tessel/t2-hardware/(threads)

Thread 11 (2015-12-19):

Update Silk For Production

johnnyman727, 2015-12-19:
Required:
- [ ] Add the [CE/FCC](http://www.sxmregulator.sx/sites/default/files/imagecache/view-850/sites/default/files/fcc_and_ce_logo.jpg) logo to a convenient place on the bottom of the board
- [ ] Update the revision tag to `TM-T2-06` (the changes with CE-approved electronics should have been `TM-T2-05` but we didn't update the silk)
- [ ] Change "Made with love by Technical Machine" to "Made with love by The Tessel Project

Optional:
- [ ] @tcr mentioned the desire to update the silk screen next to each of the pins but I'm not sure exactly what to change them to or if we even have room
- [ ] @rwaldron would like the Servo Module to have it's pins zero indexed instead of 1 for compatibility with the Johnny-Five library.

Anyone else have thoughts on this? @jiahuang @Frijol @kevinmehall @tcr @rwaldron

reconbot, 2015-12-20:
The normal module pins are also zero indexed aren't they?
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

rwaldron, 2015-12-20:
> for compatibility with the Johnny-Five library.

s/Johnny-Five library/universe/

rwaldron, 2015-12-20:
Also, it works fine with Johnny-Five.

dtex, 2015-12-20:
what Rick said

>:-(

Love y'all but seriosuly

>:-(

Frijol, 2015-12-20:
sounds good to me! The only thing I wish was better is that the labeling of what each of the pins actually is is on the back, and no one looks there... but not sure there's room on the silk to fix this.

reconbot, 2015-12-21:
I love pin labeling it makes life so much easier.

Student007, 2015-12-21:
:+1: pin labels

rwaldron, 2015-12-21:
😃

studentdanbu, 2016-09-29:
Hello Tessel-Team 😄

maybe this is not the right place for the question but it came up while planing a low scaled product.

Are there any cases you use with the Tessel 2 like those from [Spark-Fun](https://www.sparkfun.com/search/results?term=case) ?

It is about fitting external ports or used modules and of cause the screws the Tessel itself provides 4 holes to fix it in the case.

I think this is one of my major things I am unsure using the Tessel for a product (RasPi has a case on Spark Fun). If I would find a useful box I can put on a sticker ... this would be a great thing.

johnnyman727, 2016-09-29:
@studentdanbu you might want to ask on [Tessel Slack](tessel-slack.herokuapp.com) in the #community channel. I believe someone has made cases for T2 before.

Thread 16 (2016-09-22):

Outdated BOM

dbuentello, 2016-09-22:
Regenerate: https://github.com/tessel/t2-hardware/blob/master/bom/tessel-v2-parts.csv

Outdated parts:
- ATSAMD21G15A is actually g17

Im sure there are more but gave up after generator didnt work (still investigate this)

johnnyman727, 2016-09-22:
[Here is a BOM that I found from the Technical Machine archives](https://docs.google.com/spreadsheets/d/1hgn9fT9eEDG23kPYqsrsC8mXqOHHuY68sc9VK9puuPo/edit#gid=1633415522) (I scrubbed it of any pricing information in case that... matters to anyone).

It was from revision 3 of the board but we ended up producing version 4. I'm not sure if anything had changed. @ekolker might know.

Additionally, we are in the process of evaluation replacements for L201, L202, and U901 (they are End of Life). L201/2 would be replaced with MLG1005S3N9BT000 and U901 would be replaced with AP2166SGDITR-ND. @rwaldron should be able to confirm once a reworked T2 arrives at his house in a week or so.
