tessel/t2-hardware/(commit log)

2014-12-13 swapped to tm lib, 11x17 sheet size
    [mediatek.sch, v2.sch]
2014-12-13 top level hierarchy
    [mediatek.sch, v2.sch]
2014-12-13 second level schematic sheets
    [tessel-v2-coprocessor.sch, tessel-v2-io.sch, tessel-v2-power.sch]
2014-12-13 renamed files, added sub-sheets
    [tessel-v2-coprocessor.sch, tessel-v2-io.sch, tessel-v2-mediatek.sch, tessel-v2-power.sch, tessel-v2.sch]
2014-12-13 labels do not need to be bold
    [tessel-v2-mediatek.sch]
2014-12-13 added subsub schematics
    [tessel-v2-coprocessor.sch, tessel-v2-io.sch, tessel-v2-mediatek-flash.sch, tessel-v2-mediatek-ram.sch, tessel-v2-mediatek-rf.sch, tessel-v2-mediatek.sch, tessel-v2-power.sch, tessel-v2.sch]
2014-12-13 title block to all sheets
    [tessel-v2-coprocessor.sch, tessel-v2-io.sch, tessel-v2-mediatek-flash.sch, tessel-v2-mediatek-ram.sch, tessel-v2-mediatek-rf.sch, tessel-v2-mediatek.sch, tessel-v2-power.sch, tessel-v2.sch]
2014-12-14 moved RAM
    [tessel-v2-coprocessor.sch, tessel-v2-io.sch, tessel-v2-mediatek-ram.sch, tessel-v2-mediatek.sch, tessel-v2-power.sch]
2014-12-14 git/kicad test: added samd21 to coprocessor sheet
    [tessel-v2-coprocessor.sch]
2014-12-14 connecting ram
    [tessel-v2-mediatek-ram.sch]
2014-12-14 sam io labeled
    [tessel-v2-coprocessor.sch]
2014-12-14 sam io broken out to h.labels
    [tessel-v2-coprocessor.sch, tessel-v2.sch]
2014-12-14 g3 for port a, b
    [tessel-v2-coprocessor.sch, tessel-v2.sch]
2014-12-14 added ddr
    [tessel-v2-mediatek-ram.sch]
2014-12-15 coprocessor fully decoupled, etc.
    [tessel-v2-coprocessor.sch]
2014-12-15 changed 5k to 4.7k
    [tessel-v2-mediatek-ram.sch]
2014-12-15 edited samd21 sym, started power things
    [tessel-v2-coprocessor.sch, tessel-v2-mediatek-ram.sch, tessel-v2-power.sch]
2014-12-15 power plant skeleton in place
    [tessel-v2-power.sch]
2014-12-16 adding io
    [tessel-v2-io.sch, tessel-v2-mediatek.sch]
2014-12-16 somehow the libs got de-associated?
2014-12-16 readding ram
    [tessel-v2-mediatek-ram.sch]
2014-12-16 adding flash
    [tessel-v2-mediatek-flash.sch]
2014-12-16 added load switches to power schem
    [tessel-v2-power.sch]
2014-12-16 added mediatek power
    [tessel-v2-mediatek-ram.sch, tessel-v2-mediatek.sch]
2014-12-16 adding more caps
    [tessel-v2-mediatek.sch]
2014-12-16 power is mostly done
    [tessel-v2-io.sch, tessel-v2-mediatek.sch, tessel-v2-power.sch]
2014-12-16 swapped in power labels
    [tessel-v2-coprocessor.sch, tessel-v2-mediatek-flash.sch, tessel-v2-mediatek-ram.sch, tessel-v2-mediatek.sch, tessel-v2-power.sch]
2014-12-16 readding io
    [tessel-v2-io.sch]
2014-12-16 updating main schem
    [tessel-v2.sch]
2014-12-16 adding mediatek flash labels
    [tessel-v2-mediatek.sch]
2014-12-16 rf chain done (*starts praying*)
    [tessel-v2-mediatek-rf.sch]
2014-12-16 post-sch review 1. power issues addressed
    [tessel-v2-power.sch]
2014-12-16 added power h.labels to top schem
    [tessel-v2.sch]
2014-12-16 labels and series R for MT comms
    [tessel-v2-coprocessor.sch]
2014-12-17 cp pins into top sch
    [tessel-v2.sch]
2014-12-17 cleaning up ram, rf, and mediatek power
    [tessel-v2-mediatek-ram.sch, tessel-v2-mediatek-rf.sch, tessel-v2-mediatek.sch]
2014-12-17 io pins, jtag, cortex, high level pins
    [tessel-v2-coprocessor.sch, tessel-v2-io.sch, tessel-v2.sch]
2014-12-17 wiring up more i/o to cp
    [tessel-v2-coprocessor.sch, tessel-v2-io.sch, tessel-v2.sch]
2014-12-17 added power reg to downstream usb
    [tessel-v2-io.sch]
2014-12-17 labeling final nets
    [tessel-v2-io.sch]
2014-12-17 setting default boot pins on rf
    [tessel-v2-mediatek-rf.sch, tessel-v2-mediatek.sch, tessel-v2.sch]
2014-12-17 give nF some love
    [tessel-v2-io.sch, tessel-v2-mediatek-flash.sch, tessel-v2-mediatek-ram.sch, tessel-v2-mediatek.sch]
2014-12-17 second pass schem check
    [tessel-v2-coprocessor.sch, tessel-v2-io.sch, tessel-v2-mediatek-ram.sch, tessel-v2-mediatek-rf.sch, tessel-v2-mediatek.sch, tessel-v2.sch]
2014-12-17 adding netlist, checked for single-pin nets
    [tessel-v2-coprocessor.sch, tessel-v2-io.sch, tessel-v2-mediatek-flash.sch, tessel-v2-mediatek-ram.sch, tessel-v2-mediatek-rf.sch, tessel-v2-mediatek.sch, tessel-v2-power.sch]
2014-12-17 TIL: hlabel, llabel share a namespace
    [tessel-v2-coprocessor.sch, tessel-v2-io.sch, tessel-v2-mediatek-flash.sch, tessel-v2-power.sch]
2014-12-17 TIL: -am...but also P-->J
    [tessel-v2-coprocessor.sch, tessel-v2-io.sch, tessel-v2-mediatek-flash.sch, tessel-v2-mediatek-ram.sch, tessel-v2-mediatek-rf.sch, tessel-v2-mediatek.sch, tessel-v2-power.sch]
2014-12-17 starting cvpcb
    [tessel-v2-coprocessor.sch, tessel-v2-io.sch, tessel-v2-mediatek-flash.sch, tessel-v2-mediatek-ram.sch, tessel-v2-mediatek-rf.sch, tessel-v2-mediatek.sch, tessel-v2-power.sch]
2014-12-17 adding schem -> footprint
2014-12-17 swapped some caps
    [tessel-v2-io.sch, tessel-v2.sch]
2014-12-17 time to start layout...at 11:40 PM of course
    [tessel-v2.kicad_pcb]
2014-12-17 components are in
    [tessel-v2.kicad_pcb]
2014-12-17 nothing is overlapping anymore. world's dumbest import behavior, kicad
    [tessel-v2.kicad_pcb]
2014-12-17 SUBLIMETEXT AND REGEX FTW FUCK YEAH CRUISE CONTROL ALL VALUES HIDDEN ALL REFDES THE SAME SIZE
    [tessel-v2.kicad_pcb]
2014-12-17 SUBLIMEREGEXES! DOES YOUR POWER KNOW NO END?! MORE SIZING AND VISIBILITY TWEAKS!
    [tessel-v2.kicad_pcb]
2014-12-17 swapped in jtag footprint
2014-12-17 component association fixes, slogging through layout
    [tessel-v2-coprocessor.sch, tessel-v2-io.sch, tessel-v2-mediatek-flash.sch, tessel-v2-mediatek-rf.sch, tessel-v2-power.sch, tessel-v2.kicad_pcb]
2014-12-17 components grouped by sheet
    [tessel-v2-coprocessor.sch, tessel-v2-io.sch, tessel-v2-mediatek-flash.sch, tessel-v2-mediatek-ram.sch, tessel-v2-mediatek-rf.sch, tessel-v2-mediatek.sch, tessel-v2-power.sch, tessel-v2.kicad_pcb]
2014-12-17 4.7nF to 0603
    [tessel-v2.kicad_pcb]
2014-12-17 0603 footprint swap
    [tessel-v2.kicad_pcb]
2014-12-17 handoff to jia briefly for bootstrap resistors
    [tessel-v2-mediatek.sch, tessel-v2-power.sch, tessel-v2.kicad_pcb]
2014-12-17 added boot configs for mediatek
    [tessel-v2-io.sch, tessel-v2-mediatek-flash.sch, tessel-v2-mediatek-rf.sch, tessel-v2-mediatek.sch, tessel-v2.sch]
2014-12-18 changed mediatek jtag reset to porst
    [tessel-v2-coprocessor.sch, tessel-v2-io.sch, tessel-v2-mediatek-flash.sch, tessel-v2-mediatek-ram.sch, tessel-v2-mediatek-rf.sch, tessel-v2-mediatek.sch, tessel-v2-power.sch, tessel-v2.sch]
2014-12-18 wiring gpio0_1 to cs0
    [tessel-v2.sch]
2014-12-18 something about power/gnd changed...?
    [tessel-v2-coprocessor.sch, tessel-v2-io.sch, tessel-v2-mediatek-flash.sch, tessel-v2-mediatek-ram.sch, tessel-v2-mediatek-rf.sch, tessel-v2-mediatek.sch, tessel-v2-power.sch]
2014-12-18 changing to global tags
    [tessel-v2-coprocessor.sch, tessel-v2-io.sch, tessel-v2-mediatek-flash.sch, tessel-v2-mediatek-ram.sch, tessel-v2-mediatek-rf.sch, tessel-v2-mediatek.sch, tessel-v2-power.sch, tessel-v2.sch]
2014-12-18 added correct inductor footprints
2014-12-18 ram layout underway. if at first you don't succeed...
    [tessel-v2.kicad_pcb]
2014-12-18 progress...but i sort of wonder if the RAM should rotate 180deg...
    [tessel-v2.kicad_pcb]
2014-12-18 RAM almost there?
    [tessel-v2.kicad_pcb]
2014-12-18 before i mess everything up...
    [tessel-v2.kicad_pcb]
2014-12-18 handoff to jia
    [tessel-v2.kicad_pcb]
2014-12-18 early stages of usb routing
    [tessel-v2.kicad_pcb]
2014-12-18 ram routed. "done"? probably not.
    [tessel-v2.kicad_pcb]
2014-12-18 found a really good way to deal with ddr lines near SoC
    [tessel-v2.kicad_pcb]
2014-12-18 good enough for now...time to get airport breakfast
    [tessel-v2.kicad_pcb]
2014-12-18 lib refresh
    [tessel-v2-coprocessor.sch, tessel-v2-io.sch, tessel-v2-mediatek-flash.sch, tessel-v2-mediatek-ram.sch, tessel-v2-mediatek-rf.sch, tessel-v2-mediatek.sch, tessel-v2-power.sch, tessel-v2.kicad_pcb]
2014-12-18 handoff to jia for cvpcb
    [tessel-v2.kicad_pcb]
2014-12-18 cp/soc bridge
    [tessel-v2.kicad_pcb]
2014-12-18 why did you put in so many TH TPs, jia? why?
    [tessel-v2.kicad_pcb]
2014-12-19 finished usb wiring
    [tessel-v2-coprocessor.sch, tessel-v2-io.sch, tessel-v2-mediatek-flash.sch, tessel-v2-mediatek-ram.sch, tessel-v2-mediatek-rf.sch, tessel-v2-mediatek.sch, tessel-v2-power.sch, tessel-v2.kicad_pcb]
2014-12-19 added rest of caps to usb
    [tessel-v2.kicad_pcb]
2014-12-19 did this work?
    [tessel-v2.kicad_pcb]
2014-12-19 some silk resize
    [tessel-v2.kicad_pcb]
2014-12-19 more silk
    [tessel-v2.kicad_pcb]
2014-12-19 time for bed
    [tessel-v2.kicad_pcb]
2014-12-19 routed the co-processor
    [tessel-v2-io.sch, tessel-v2-mediatek-flash.sch, tessel-v2-mediatek-rf.sch, tessel-v2-power.sch, tessel-v2.kicad_pcb]
2014-12-19 rf mostly done
    [tessel-v2-mediatek-rf.sch, tessel-v2.kicad_pcb]
2014-12-19 damn rf decoupling
    [tessel-v2.kicad_pcb]
2014-12-19 rf done...knock on wood
    [tessel-v2.kicad_pcb]
2014-12-19 all that is left (heh...all) is power plant and decoupling the MT
    [tessel-v2.kicad_pcb]
2014-12-19 power systems laid out, not positioned
    [tessel-v2.kicad_pcb]
2014-12-20 fixed wrong net names for pa_cs and pb_cs
    [tessel-v2-coprocessor.sch, tessel-v2-io.sch, tessel-v2.kicad_pcb, tessel-v2.sch]
2014-12-20 1.2v decoupling, moved traces under the sam gnd pad...
    [tessel-v2-coprocessor.sch, tessel-v2-io.sch, tessel-v2-mediatek-flash.sch, tessel-v2-mediatek-rf.sch, tessel-v2-power.sch, tessel-v2.kicad_pcb]
2014-12-20 cp power placed
    [tessel-v2.kicad_pcb]
2014-12-20 cp power mostly done
    [tessel-v2.kicad_pcb]
2014-12-20 jia...wahy did you route power? we have planes for this.
    [tessel-v2.kicad_pcb]
2014-12-20 1.8v work
    [tessel-v2.kicad_pcb]
2014-12-20 one rf chain decoupled
    [tessel-v2.kicad_pcb]
2014-12-20 gnd plane
    [tessel-v2.kicad_pcb]
2014-12-21 gnd on MT
    [tessel-v2.kicad_pcb]
2014-12-21 routed everything but 3.3V
    [tessel-v2.kicad_pcb]
2014-12-21 via stakes in
    [tessel-v2.kicad_pcb]
2014-12-21 no more unconnected nets
    [tessel-v2.kicad_pcb]
2014-12-21 all drc passing
    [tessel-v2.kicad_pcb]
2014-12-21 finished all copper pours
    [tessel-v2.kicad_pcb]
2014-12-21 adding gerbers
    [tessel-v2-B_Cu.gbr, tessel-v2-B_Mask.gbr, tessel-v2-B_Paste.gbr, tessel-v2-B_SilkS.gbr, tessel-v2-Edge_Cuts.gbr, tessel-v2-F_Cu.gbr, tessel-v2-F_Mask.gbr, tessel-v2-F_Paste.gbr]
2014-12-21 jia: use a grid. always. never less than 5 mils unless DRC is complaining.
    [tessel-v2.kicad_pcb]
2014-12-21 use design rules
    [tessel-v2.kicad_pcb]
2014-12-21 design rules work
    [tessel-v2.kicad_pcb]
2014-12-21 power cleanup
    [tessel-v2.kicad_pcb]
2014-12-21 rf rework
    [tessel-v2.kicad_pcb]
2014-12-21 ufl gnd stake
    [tessel-v2.kicad_pcb]
2014-12-21 1.8 decoupling cap
    [tessel-v2.kicad_pcb]
2014-12-21 ram lines
    [tessel-v2.kicad_pcb]
2014-12-21 gnd things
    [tessel-v2.kicad_pcb]
2014-12-21 leds on power rails
    [tessel-v2-power.sch, tessel-v2.sch]
2014-12-21 dont even remember what i fixed
    [tessel-v2.kicad_pcb]
2014-12-21 maybe now the leds propogated
    [tessel-v2-coprocessor.sch, tessel-v2-io.sch, tessel-v2-power.sch]
2014-12-22 added user led to HOLD line, added cap footprints on bottom, passing drc again
    [tessel-v2-coprocessor.sch, tessel-v2-io.sch, tessel-v2-mediatek-flash.sch, tessel-v2-mediatek-rf.sch, tessel-v2-mediatek.sch, tessel-v2-power.sch, tessel-v2.kicad_pcb]
2014-12-22 fixed drc
    [tessel-v2-B_Cu.gbr, tessel-v2-B_Mask.gbr, tessel-v2-B_Paste.gbr, tessel-v2-B_SilkS.gbr, tessel-v2-Edge_Cuts.gbr, tessel-v2-F_Cu.gbr, tessel-v2-F_Mask.gbr, tessel-v2-F_Paste.gbr]
2014-12-22 some cleanup?
    [tessel-v2-B_Cu.gbr, tessel-v2-B_Mask.gbr, tessel-v2-B_Paste.gbr, tessel-v2-B_SilkS.gbr, tessel-v2-Edge_Cuts.gbr, tessel-v2-F_Cu.gbr, tessel-v2-F_Mask.gbr, tessel-v2-F_Paste.gbr]
2014-12-23 modified footprint silk
    [tessel-v2-B_Cu.gbr, tessel-v2-B_Mask.gbr, tessel-v2-B_Paste.gbr, tessel-v2-B_SilkS.gbr, tessel-v2-Edge_Cuts.gbr, tessel-v2-F_Cu.gbr, tessel-v2-F_Mask.gbr, tessel-v2-F_Paste.gbr]
2015-01-14 updated with new mediatek pinout
    [tessel-v2.kicad_pcb]
2015-01-19 swapped load switch
    [tessel-v2-power.sch]
2015-01-19 swapped 3.3 vregs
    [tessel-v2-power.sch]
2015-01-19 power plant swapped to AP3417/8
    [tessel-v2-power.sch]
2015-01-19 1.8 should be calibrated to 1.8...
    [tessel-v2-power.sch]
2015-01-19 hopefully my swapping the gpio1/sc0 nonsense worked out...
    [tessel-v2-coprocessor.sch, tessel-v2-io.sch, tessel-v2.sch]
2015-01-19 pop the port power caps, note regarding real component values
    [tessel-v2-power.sch]
2015-01-20 pull resistors on port power enable lines
    [tessel-v2-power.sch, tessel-v2.sch]
2015-01-20 swapped tx/rx on bridge
    [tessel-v2.sch]
2015-01-20 (c) 2015
    [tessel-v2-coprocessor.sch, tessel-v2-io.sch, tessel-v2-mediatek-flash.sch, tessel-v2-mediatek-ram.sch, tessel-v2-mediatek-rf.sch, tessel-v2-mediatek.sch, tessel-v2-power.sch, tessel-v2.sch]
2015-01-20 swapped micro io for interrupts, cp power always on
    [tessel-v2-coprocessor.sch, tessel-v2-power.sch]
2015-01-21 h. pin cleanup
    [tessel-v2.sch]
2015-01-21 added pcb antennas, more annotation
    [tessel-v2-coprocessor.sch, tessel-v2-io.sch, tessel-v2-mediatek-rf.sch, tessel-v2-power.sch]
2015-01-21 apologies jia... needed to re-number things
    [tessel-v2-coprocessor.sch, tessel-v2-io.sch, tessel-v2-mediatek-flash.sch, tessel-v2-mediatek-ram.sch, tessel-v2-mediatek-rf.sch, tessel-v2-mediatek.sch, tessel-v2-power.sch]
2015-01-21 swd/jtag pinswaps and LEDs
    [tessel-v2-io.sch, tessel-v2-mediatek-flash.sch, tessel-v2-mediatek-rf.sch, tessel-v2-mediatek.sch, tessel-v2.sch]
2015-01-21 re-re-re-etc. annotate
    [tessel-v2-io.sch, tessel-v2-mediatek-flash.sch, tessel-v2-mediatek-rf.sch, tessel-v2-mediatek.sch]
2015-01-21 swapped to "X DNP" from "X, DNP"; reassign and whatnot
    [tessel-v2-coprocessor.sch, tessel-v2-io.sch, tessel-v2-mediatek-flash.sch, tessel-v2-mediatek-ram.sch, tessel-v2-mediatek-rf.sch, tessel-v2-mediatek.sch, tessel-v2-power.sch]
2015-01-21 datasheets, refdes, netlists, and component mappings
    [tessel-v2-io.sch, tessel-v2-mediatek-flash.sch, tessel-v2-mediatek-ram.sch, tessel-v2-mediatek-rf.sch, tessel-v2-mediatek.sch, tessel-v2-power.sch]
2015-01-22 1%, DNP, etc
    [tessel-v2-mediatek-rf.sch, tessel-v2-power.sch]
2015-01-22 new ports/io idea
    [tessel-v2-coprocessor.sch, tessel-v2-io.sch]
2015-01-22 imported the new cmp file into the pcb
    [tessel-v2.kicad_pcb]
2015-01-22 bom file added
    [tessel-v2.csv]
2015-01-22 moved parts around, Green-->GREEN
    [tessel-v2-power.sch, tessel-v2.kicad_pcb]
2015-01-22 sudo unroute -a
    [tessel-v2.kicad_pcb]
2015-01-22 added mount holes, 3" guide lines... it will be a miracle if it fits
    [tessel-v2-io.sch, tessel-v2.kicad_pcb, tessel-v2.sch]
2015-01-22 starting RAM layout and misc. sch edits so that there is no back annotation
    [tessel-v2-io.sch, tessel-v2.kicad_pcb]
2015-01-23 THIS IS SO MUCH EASIER WHEN YOU FIND THE RIGHT ORIENTATION
    [tessel-v2.kicad_pcb]
2015-01-23 let the length-matching begin
    [tessel-v2.kicad_pcb]
2015-01-23 cross check with jia
    [tessel-v2-mediatek-rf.sch, tessel-v2.kicad_pcb]
2015-01-24 adding in part swaps
    [tessel-v2-coprocessor.sch, tessel-v2-io.sch]
2015-01-24 added part swaps to io
    [tessel-v2-coprocessor.sch, tessel-v2-io.sch]
2015-01-24 finished associating parts with footprints
    [tessel-v2.csv]
2015-01-24 another sync with jia?
    [tessel-v2.kicad_pcb]
2015-01-24 more sync
    [tessel-v2.kicad_pcb]
2015-01-25 usb lines routed
    [tessel-v2-coprocessor.sch, tessel-v2-io.sch, tessel-v2-mediatek-flash.sch, tessel-v2-mediatek-rf.sch, tessel-v2-power.sch, tessel-v2.kicad_pcb]
2015-01-25 usb & ethernet routed
    [tessel-v2-io.sch, tessel-v2.kicad_pcb]
2015-01-26 power plant layout, vreg enable optimization
    [tessel-v2-coprocessor.sch, tessel-v2-io.sch, tessel-v2-power.sch, tessel-v2.kicad_pcb]
2015-01-26 if you go for dual-sided you may as well really go for it... moved some usb things around
    [tessel-v2.kicad_pcb]
2015-01-26 ethernet lines length-matched to 80 microns. yes, you read that right.
    [tessel-v2.kicad_pcb]
2015-01-26 more ethernet, found a netlist error, power plant done
    [tessel-v2-coprocessor.sch, tessel-v2-io.sch, tessel-v2-power.sch, tessel-v2.kicad_pcb]
2015-01-26 usb esd
    [tessel-v2-io.sch, tessel-v2.kicad_pcb]
2015-01-26 mostly most of the cp
    [tessel-v2.kicad_pcb]
2015-01-26 more cp things, 33cp is in place
    [tessel-v2-mediatek.sch, tessel-v2.kicad_pcb]
2015-01-26 going home before i decide to do the rf power...
    [tessel-v2.kicad_pcb]
2015-01-26 pushing for jia
    [tessel-v2-mediatek-rf.sch, tessel-v2.kicad_pcb]
2015-01-26 11x17, please
    [tessel-v2-mediatek.sch]
2015-01-27 post-schematic review. changes in.
    [tessel-v2-coprocessor.sch, tessel-v2-io.sch, tessel-v2-mediatek-flash.sch, tessel-v2-mediatek-ram.sch, tessel-v2-mediatek-rf.sch, tessel-v2-mediatek.sch, tessel-v2-power.sch, tessel-v2.kicad_pcb]
2015-01-27 added esd/gnd loop deterrent to sockets
    [tessel-v2-io.sch, tessel-v2-mediatek-rf.sch, tessel-v2-mediatek.sch]
2015-01-27 stupid thing did not annotate properly
    [tessel-v2-io.sch, tessel-v2.sch]
2015-01-27 derating load caps
    [tessel-v2-coprocessor.sch, tessel-v2-io.sch, tessel-v2-mediatek.sch]
2015-01-27 pulled jia's changes into the layout
    [tessel-v2.kicad_pcb]
2015-01-27 redid usb power
    [tessel-v2.kicad_pcb]
2015-01-27 more usb power...
    [tessel-v2.kicad_pcb]
2015-01-27 "power" and dinner
    [tessel-v2.kicad_pcb]
2015-01-27 swapped down to a 4-pin "gpio bank"
    [tessel-v2-io.sch, tessel-v2.kicad_pcb]
2015-01-27 fixed usb1.8v, routed esd
    [tessel-v2-io.sch, tessel-v2.kicad_pcb]
2015-01-27 added bom exporter
    [tessel-v2-parts.csv]
2015-01-28 rf power, removed 0R between RF_FEED and UFL
    [tessel-v2-mediatek-rf.sch, tessel-v2.kicad_pcb]
2015-01-28 rf power schem error...
    [tessel-v2-mediatek.sch, tessel-v2.kicad_pcb]
2015-01-28 placing caps and moving usb power traces
    [tessel-v2.kicad_pcb]
2015-01-28 power decoupling
    [tessel-v2.kicad_pcb]
2015-01-28 amazingly, passing drc was easy! oh wait... still need to do the RAM and RF sections...
    [tessel-v2-mediatek.sch, tessel-v2.kicad_pcb]
2015-01-28 from whence did all these 1.2V pins suddenly appear?!
    [tessel-v2.kicad_pcb]
2015-01-28 1.2 is routed. ooof...
    [tessel-v2.kicad_pcb]
2015-01-28 some bridge things...and bed
    [tessel-v2.kicad_pcb]
2015-01-28 5V routed to all regs...except 33MT
    [tessel-v2.kicad_pcb]
2015-01-28 esd ties
    [tessel-v2.kicad_pcb]
2015-01-28 starting on RF
    [tessel-v2.kicad_pcb]
2015-01-28 removed chip antennas. made ground planes.
    [tessel-v2-io.sch, tessel-v2-mediatek-rf.sch, tessel-v2-mediatek.sch, tessel-v2.kicad_pcb]
2015-01-28 quick drc touchup
    [tessel-v2.kicad_pcb]
2015-01-29 95% there and about to rip up the RAM to length-match it
    [tessel-v2.kicad_pcb]
2015-01-29 final bom...for this rev
    [tessel-v2.csv]
2015-01-29 ready to match, mk 2 - top, 225deg
    [tessel-v2.kicad_pcb]
2015-01-29 the magic number is 29...or will be, rather
    [tessel-v2.kicad_pcb]
2015-01-29 clocks hit spec! now on to the other hundred signals...
    [tessel-v2.kicad_pcb]
2015-01-29 slow and steady progress
    [tessel-v2.kicad_pcb]
2015-01-29 striking distance
    [tessel-v2.kicad_pcb]
2015-01-29 almost there...
    [tessel-v2.kicad_pcb]
2015-01-29 ddr2 length-matched to 0.23mm...but i think that will have to get touched up after other things get grounded, say.
    [tessel-v2.kicad_pcb]
2015-01-29 found a ground, passed drc, got better matching. still need to find more grounds, though...
    [tessel-v2.kicad_pcb]
2015-01-29 getting power out is a lot easier than i thought it would be. still a pain, but easier than expected.
2015-01-29 We almost forgot to power the RF PA. I have no more words.
    [tessel-v2-mediatek.sch]
2015-01-29 exported to layout, etc.
    [tessel-v2-coprocessor.sch, tessel-v2-io.sch, tessel-v2-mediatek-flash.sch, tessel-v2-mediatek-ram.sch, tessel-v2-mediatek-rf.sch, tessel-v2-mediatek.sch, tessel-v2-power.sch]
2015-01-30 ethernet length-matched
    [tessel-v2-coprocessor.sch, tessel-v2-io.sch, tessel-v2-power.sch]
2015-01-30 usb gnd staked
2015-01-30 fixed gnd staking disassociation...
2015-01-30 segmented power plane for RF PAs as per design note
2015-01-31 layout review
    [tessel-v2-io.sch]
2015-01-31 new bom (added 0.4 cents in parts and 10 cents to the assembly cost)
    [tessel-v2.csv]
2015-01-31 good night and good luck.
    [tessel-v2.kicad_pcb]
2015-02-12 0603 resistor swapped
    [tessel-v2-coprocessor.sch, tessel-v2-io.sch, tessel-v2-mediatek-flash.sch, tessel-v2-mediatek-ram.sch, tessel-v2-mediatek-rf.sch, tessel-v2-mediatek.sch, tessel-v2-power.sch, tessel-v2.kicad_pcb]
2015-02-12 0805 caps and inductors (as resistors)
    [tessel-v2.kicad_pcb]
2015-02-12 0404R swapped
    [tessel-v2.kicad_pcb]
2015-02-12 0402 caps
    [tessel-v2.kicad_pcb]
2015-02-13 esd diodes
    [tessel-v2.kicad_pcb]
2015-02-13 top renders well
    [tessel-v2.kicad_pcb]
2015-02-13 proper qfn for SAM
    [tessel-v2.kicad_pcb]
2015-02-13 logo? logo.
    [tessel-v2-coprocessor.sch, tessel-v2-io.sch, tessel-v2-mediatek-flash.sch, tessel-v2-mediatek-ram.sch, tessel-v2-mediatek-rf.sch, tessel-v2-mediatek.sch, tessel-v2-power.sch, tessel-v2.kicad_pcb]
2015-02-13 done with renders for the day
    [tessel-v2.sch]
2015-02-14 added new logo
    [tessel-v2.kicad_pcb]
2015-02-20 working towards pin muxing for v2v3 and general schematic cleanup
    [tessel-v2-coprocessor.sch, tessel-v2-io.sch, tessel-v2-mediatek-ram.sch, tessel-v2-mediatek.sch, tessel-v2-power.sch, tessel-v2.sch]
2015-02-20 most schematic changes done, major refactoring underway
    [tessel-v2-coprocessor.sch, tessel-v2-io.sch, tessel-v2-mediatek-flash.sch, tessel-v2-mediatek-ram.sch, tessel-v2-mediatek-rf.sch, tessel-v2-mediatek-usb.sch, tessel-v2-mediatek.sch, tessel-v2-power.sch]
2015-02-21 still refactoring. usb is a pain
    [tessel-v2-coprocessor.sch, tessel-v2-io.sch, tessel-v2-mediatek-flash.sch, tessel-v2-mediatek-ram.sch, tessel-v2-mediatek-usb.sch, tessel-v2-mediatek.sch]
2015-02-21 last but not least: refactoring mediatek itself
    [tessel-v2-coprocessor.sch, tessel-v2-io.sch, tessel-v2-mediatek-rf.sch, tessel-v2-mediatek-usb.sch, tessel-v2-mediatek.sch, tessel-v2-power.sch]
2015-02-21 refactoring "complete"; verification begins...later
    [tessel-v2-mediatek-ram.sch, tessel-v2-mediatek.sch]
2015-02-23 reset annotation
    [tessel-v2-coprocessor.sch, tessel-v2-io.sch, tessel-v2-mediatek-flash.sch, tessel-v2-mediatek-ram.sch, tessel-v2-mediatek-rf.sch, tessel-v2-mediatek-usb.sch, tessel-v2-mediatek.sch, tessel-v2-power.sch]
2015-02-23 annotation did not take?
    [tessel-v2-coprocessor.sch, tessel-v2-io.sch, tessel-v2-mediatek-flash.sch, tessel-v2-mediatek-ram.sch, tessel-v2-mediatek-rf.sch, tessel-v2-mediatek-usb.sch, tessel-v2-mediatek.sch, tessel-v2-power.sch]
2015-02-23 post-quick review from refactor
    [tessel-v2-coprocessor.sch, tessel-v2-io.sch, tessel-v2-mediatek-flash.sch, tessel-v2-mediatek-ram.sch, tessel-v2-mediatek-rf.sch, tessel-v2-mediatek-usb.sch, tessel-v2-mediatek.sch, tessel-v2-power.sch]
2015-02-24 value optimization for the sake of bom complexity
    [tessel-v2-coprocessor.sch, tessel-v2-io.sch, tessel-v2-mediatek-rf.sch, tessel-v2-mediatek-usb.sch, tessel-v2-mediatek.sch, tessel-v2.sch]
2015-02-24 ready to merge back in
    [tessel-v2-mediatek-rf.sch]
2015-02-24 tagged 2 usb ports as optional
    [tessel-v2-mediatek-usb.sch]
2015-02-24 removed second set of usb ports
    [tessel-v2-mediatek-usb.sch]
2015-02-24 1) can't believe i started from scratch 2) single best feature in today's kicad build: allign/distribute.
    [tessel-v2-coprocessor.sch, tessel-v2-io.sch, tessel-v2-mediatek-flash.sch, tessel-v2-mediatek-ram.sch, tessel-v2-mediatek-rf.sch, tessel-v2-mediatek-usb.sch, tessel-v2-mediatek.sch, tessel-v2-power.sch]
2015-02-24 rought placement of power plants, main ics
    [tessel-v2.kicad_pcb]
2015-02-24 sadly, we may need to rotate the mediatek...
    [tessel-v2-coprocessor.sch, tessel-v2-mediatek-usb.sch, tessel-v2-power.sch, tessel-v2.kicad_pcb]
2015-02-24 mostly just messing aorund with mask and pours. also placed more things and shrunk the board.
    [tessel-v2.kicad_pcb]
2015-02-24 "it would be great if it were smaller" says everyone always
    [tessel-v2.kicad_pcb]
2015-02-24 tentatively placed power plants
    [tessel-v2.kicad_pcb]
2015-02-24 changes to usb domain: enable 3V3 reg, tie vbusm to mt33
    [tessel-v2-mediatek-usb.sch]
2015-02-24 back-propogated componet information, placed lots of things
    [tessel-v2-io.sch, tessel-v2-mediatek-flash.sch, tessel-v2-mediatek-ram.sch, tessel-v2-mediatek-rf.sch, tessel-v2-mediatek-usb.sch, tessel-v2-mediatek.sch, tessel-v2-power.sch, tessel-v2.kicad_pcb]
2015-02-25 placement completele! let the routing begin!
    [tessel-v2-io.sch, tessel-v2-mediatek-usb.sch, tessel-v2.kicad_pcb, tessel-v2.sch]
2015-02-25 "wait but real quick can you align the double diamonds" -- kelsey" the answer is "maybe; it depends on the ethernet lines"
    [tessel-v2.kicad_pcb]
2015-02-25 hid some values. handoof to jia.
    [tessel-v2.kicad_pcb]
2015-02-25 routed port b
    [tessel-v2.kicad_pcb]
2015-02-25 cp routed
    [tessel-v2.kicad_pcb]
2015-02-25 did most of usb
    [tessel-v2.kicad_pcb]
2015-02-26 routed 98% of the CP, USB, ETH. normalized silk.
    [tessel-v2-io.sch, tessel-v2.kicad_pcb]
2015-02-26 mostly done with everything except RAM
    [tessel-v2-io.sch, tessel-v2.kicad_pcb]
2015-02-26 mostly just the ram left. downsized its land pattern.
    [tessel-v2.kicad_pcb]
2015-02-26 ram routing is going...but not well and not matched as of yet :/
    [tessel-v2.kicad_pcb]
2015-02-27 length-matching remains
    [tessel-v2.kicad_pcb]
2015-02-27 mostly removed pwr plane violations. mostly.
    [tessel-v2.kicad_pcb]
2015-02-27 steady progress
    [tessel-v2.kicad_pcb]
2015-02-27 still going...
    [tessel-v2.kicad_pcb]
2015-02-27 swaped out compoents
    [tessel-v2.kicad_pcb]
2015-03-02 length matching continues...
    [tessel-v2.kicad_pcb]
2015-03-02 length matching...done!
    [tessel-v2.kicad_pcb]
2015-03-02 placed, routed 1.8V power
    [tessel-v2.kicad_pcb]
2015-03-02 starting to really route power... 1.2 and 1.8 will be a challenge
    [tessel-v2.kicad_pcb]
2015-03-02 got 1.2, but i had to move a cap. sorry, jia.
    [tessel-v2.kicad_pcb]
2015-03-02 oh right... we wanted to be able to cross-reprogram...
    [tessel-v2.kicad_pcb]
2015-03-02 routed and length matched
    [tessel-v2.kicad_pcb]
2015-03-02 fully routed with sca/scl pulls
    [tessel-v2-coprocessor.sch, tessel-v2-io.sch, tessel-v2-mediatek-flash.sch, tessel-v2-mediatek-ram.sch, tessel-v2-mediatek-rf.sch, tessel-v2-mediatek-usb.sch, tessel-v2-mediatek.sch, tessel-v2-power.sch]
2015-03-02 added fiducials
    [tessel-v2.sch]
2015-03-03 design locked for tm-t2-03
    [tessel-v2.kicad_pcb]
2015-03-03 tm-t2-03 gerbers
    [tessel-v2-B_Cu.gbr, tessel-v2-B_Mask.gbr, tessel-v2-B_Paste.gbr, tessel-v2-B_SilkS.gbr, tessel-v2-Edge_Cuts.gbr, tessel-v2-F_Cu.gbr, tessel-v2-F_Mask.gbr, tessel-v2-F_Paste.gbr]
2015-03-03 paste removed on fiducials for tm-t2-03
    [tessel-v2-B_Cu.gbr, tessel-v2-B_Mask.gbr, tessel-v2-B_Paste.gbr, tessel-v2-B_SilkS.gbr, tessel-v2-Edge_Cuts.gbr, tessel-v2-F_Cu.gbr, tessel-v2-F_Mask.gbr, tessel-v2-F_Paste.gbr]
2015-03-03 3d models for tm-t2-03
    [tessel-v2.kicad_pcb]
2015-03-03 removed models from DNP parts
    [tessel-v2.kicad_pcb]
2015-03-03 crept mask in on fiducials
    [tessel-v2.kicad_pcb]
2015-03-03 removed 3d models for debug headers
    [tessel-v2.kicad_pcb]
2015-03-03 3d model tweaks
    [tessel-v2.kicad_pcb]
2015-03-03 cleaned up schematics for release (tm-t2-03)
    [tessel-v2-coprocessor.sch, tessel-v2-io.sch, tessel-v2-mediatek-flash.sch, tessel-v2-mediatek-ram.sch, tessel-v2-mediatek-rf.sch, tessel-v2-mediatek-usb.sch, tessel-v2-mediatek.sch, tessel-v2-power.sch]
2015-03-04 latest bom
    [tessel-v2.csv]
2015-03-13 updated license on schematic
    [tessel-v2-coprocessor.sch, tessel-v2-io.sch, tessel-v2-mediatek-flash.sch, tessel-v2-mediatek-ram.sch, tessel-v2-mediatek-rf.sch, tessel-v2-mediatek-usb.sch, tessel-v2-mediatek.sch, tessel-v2-power.sch]
2015-03-13 added license to pcb
    [tessel-v2.kicad_pcb]
2015-03-13 incremented version number
    [tessel-v2-coprocessor.sch, tessel-v2-io.sch, tessel-v2-mediatek-flash.sch, tessel-v2-mediatek-ram.sch, tessel-v2-mediatek-rf.sch, tessel-v2-mediatek-usb.sch, tessel-v2-mediatek.sch, tessel-v2-power.sch]
2015-03-14 moving to intrernal RLC symbols...~half way there, by sheets
    [tessel-v2-coprocessor.sch, tessel-v2-mediatek-flash.sch, tessel-v2-power.sch]
2015-03-14 swapped out all RLCs
    [tessel-v2-coprocessor.sch, tessel-v2-io.sch, tessel-v2-mediatek-flash.sch, tessel-v2-mediatek-ram.sch, tessel-v2-mediatek-rf.sch, tessel-v2-mediatek-usb.sch, tessel-v2-mediatek.sch, tessel-v2-power.sch]
2015-03-14 exportted nextlist to make sure nothing broke in the swap. as usual, git is bad at kicad files, but i believe nothing broke.
2015-03-14 project save
    [tessel-v2-coprocessor.sch, tessel-v2-io.sch, tessel-v2-mediatek-flash.sch, tessel-v2-mediatek-ram.sch, tessel-v2-mediatek-rf.sch, tessel-v2-mediatek-usb.sch, tessel-v2-mediatek.sch, tessel-v2-power.sch]
2015-03-16 swapped pull resistor direction for module port power enable, kept footprint as dnp
    [tessel-v2-power.sch]
2015-03-16 added pull resistors to usb overcurrent flags
    [tessel-v2-mediatek-usb.sch]
2015-03-16 swapped to 4-pin header for debug uart
    [tessel-v2-io.sch]
2015-03-16 added 5v headers
    [tessel-v2-power.sch]
2015-03-16 added testpoints to swd and power
    [tessel-v2-coprocessor.sch, tessel-v2-power.sch]
2015-03-16 turn down blue
    [tessel-v2-io.sch]
2015-03-16 netlist, etc.
    [tessel-v2-coprocessor.sch, tessel-v2-io.sch, tessel-v2-mediatek-flash.sch, tessel-v2-mediatek-ram.sch, tessel-v2-mediatek-rf.sch, tessel-v2-mediatek-usb.sch, tessel-v2-mediatek.sch, tessel-v2-power.sch]
2015-03-17 propogated changes through layout
    [tessel-v2-coprocessor.sch, tessel-v2-io.sch, tessel-v2-mediatek-flash.sch, tessel-v2-mediatek-ram.sch, tessel-v2-mediatek-rf.sch, tessel-v2-mediatek-usb.sch, tessel-v2-mediatek.sch, tessel-v2-power.sch]
2015-03-17 no via in pad, please
    [tessel-v2.kicad_pcb]
2015-03-18 added 10k pu to sam !cs
    [tessel-v2-coprocessor.sch, tessel-v2-io.sch, tessel-v2-mediatek-flash.sch, tessel-v2-mediatek-ram.sch, tessel-v2-mediatek-rf.sch, tessel-v2-mediatek-usb.sch, tessel-v2-mediatek.sch, tessel-v2-power.sch]
2015-03-20 added pulls to usb ovc flags, dnp jumpers between MT USB and port 1, 5v to power pins
    [tessel-v2-mediatek-usb.sch, tessel-v2.kicad_pcb]
2015-03-20 swapped led resistor values, package for some dnps, exported to cmp and net
    [tessel-v2-io.sch, tessel-v2-mediatek-usb.sch, tessel-v2-power.sch]
2015-03-21 pushed changes into layout. still needs to pass drc
    [tessel-v2.kicad_pcb]
2015-03-26 led and related resistor changeover
    [tessel-v2-coprocessor.sch, tessel-v2-power.sch]
2015-03-26 swapped load switches
    [tessel-v2-power.sch]
2015-03-27 swapped to a single 33 regulator...
    [tessel-v2-power.sch]
2015-03-27 more caps
    [tessel-v2-power.sch]
2015-03-28 power mux is not done...oof.
    [tessel-v2-coprocessor.sch, tessel-v2-io.sch, tessel-v2-mediatek-flash.sch, tessel-v2-mediatek-ram.sch, tessel-v2-mediatek-rf.sch, tessel-v2-mediatek-usb.sch, tessel-v2-mediatek.sch, tessel-v2-power.sch]
2015-03-30 reverse protection with backfeed done, power plant rewoked. time to to the layout.
    [tessel-v2-coprocessor.sch, tessel-v2-io.sch, tessel-v2-mediatek-flash.sch, tessel-v2-mediatek-ram.sch, tessel-v2-mediatek-rf.sch, tessel-v2-mediatek-usb.sch, tessel-v2-mediatek.sch, tessel-v2-power.sch]
2015-03-30 bigger SAM
    [tessel-v2-coprocessor.sch, tessel-v2-power.sch]
2015-03-30 imported netlist to pcb
    [tessel-v2-coprocessor.sch, tessel-v2.kicad_pcb]
2015-03-31 pushed latest through to layout, passes drc
    [tessel-v2-coprocessor.sch, tessel-v2-io.sch, tessel-v2-mediatek-flash.sch, tessel-v2-mediatek-ram.sch, tessel-v2-mediatek-rf.sch, tessel-v2-mediatek-usb.sch, tessel-v2-mediatek.sch, tessel-v2-power.sch]
2015-03-31 saved, closed
    [tessel-v2-power.sch]
2015-04-01 connector footprint updates...and more
    [tessel-v2.kicad_pcb]
2015-04-10 fixed uUSB 3d model
    [tessel-v2.kicad_pcb]
2015-04-16 added nasty RC time constant hack to USB overcurrent flags
    [tessel-v2-mediatek-usb.sch]
2015-04-16 schematic cleanup
    [tessel-v2-mediatek-usb.sch]
2015-04-16 changes library include to use ${KIPRJMOD} variable to locate tm-kicad-library
2015-04-17 annotation, netlist, part assignment
    [tessel-v2-coprocessor.sch, tessel-v2-power.sch]
2015-04-17 pushed changes through to layout, passes DRC
    [tessel-v2-mediatek-usb.sch, tessel-v2-power.sch, tessel-v2.kicad_pcb]
2015-04-17 updated bom
    [tessel-v2.csv]
2015-04-17 gerbers to match
    [tessel-v2-B_Cu.gbr, tessel-v2-B_Mask.gbr, tessel-v2-B_Paste.gbr, tessel-v2-B_SilkS.gbr, tessel-v2-Edge_Cuts.gbr, tessel-v2-F_Cu.gbr, tessel-v2-F_Mask.gbr, tessel-v2-F_Paste.gbr]
2015-04-20 picked a pmos
    [tessel-v2-power.sch]
2015-04-20 pushed pmos data into layout
    [tessel-v2.kicad_pcb]
2015-04-20 silk normalized to 0.8mm size, 0.1mm width. not optimized.
    [tessel-v2.kicad_pcb]
2015-04-21 considerable progress on silk
    [tessel-v2.kicad_pcb]
2015-04-21 gitignore now includes the pcb temp file
2015-04-21 abort, switching to 0.7mm text
    [tessel-v2.kicad_pcb]
2015-04-21 still working on silk placement
    [tessel-v2.kicad_pcb]
2015-04-21 top silk is most of the way there
    [tessel-v2.kicad_pcb]
2015-04-21 silk is 95% there, fixed some 3D models
    [tessel-v2-coprocessor.sch, tessel-v2-io.sch, tessel-v2-mediatek-flash.sch, tessel-v2-mediatek-ram.sch, tessel-v2-mediatek-rf.sch, tessel-v2-mediatek-usb.sch, tessel-v2-mediatek.sch, tessel-v2-power.sch]
2015-04-21 ufls' refdes to j###, pass drc
    [tessel-v2-mediatek-rf.sch, tessel-v2.kicad_pcb]
2015-04-21 led silk
    [tessel-v2.kicad_pcb]
2015-04-23 atmel recommends a bigger vddcore cap, apparently
    [tessel-v2-coprocessor.sch, tessel-v2-io.sch, tessel-v2-mediatek-flash.sch, tessel-v2-mediatek-ram.sch, tessel-v2-mediatek-rf.sch, tessel-v2-mediatek-usb.sch, tessel-v2-mediatek.sch, tessel-v2-power.sch]
2015-04-28 some update flipped the leds. fixed all the way through to gerbers.
    [tessel-v2-B_Cu.gbr, tessel-v2-B_Mask.gbr, tessel-v2-B_Paste.gbr, tessel-v2-B_SilkS.gbr, tessel-v2-Edge_Cuts.gbr, tessel-v2-F_Cu.gbr, tessel-v2-F_Mask.gbr, tessel-v2-F_Paste.gbr]
2015-06-29 must force insert on all smt parts in pos file to get good data
2015-06-29 whaddup, uUSB? thanks for finally getting on the board...
2015-09-07 addresses EMC issues, adds placeholder FCC, CE, etc. silk
    [tessel-v2-coprocessor.sch, tessel-v2-io.sch, tessel-v2-mediatek-flash.sch, tessel-v2-mediatek-ram.sch, tessel-v2-mediatek-rf.sch, tessel-v2-mediatek-usb.sch, tessel-v2-mediatek.sch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]
2015-09-07 silk optimization, gogogo!
    [tessel-v2-B_Cu.gbr, tessel-v2-B_Mask.gbr, tessel-v2-B_Paste.gbr, tessel-v2-B_SilkS.gbr, tessel-v2-Edge_Cuts.gbr, tessel-v2-F_Cu.gbr, tessel-v2-F_Mask.gbr, tessel-v2-F_Paste.gbr]
2015-09-07 adds exports without any fcc, ce logos or id numbers
    [tessel-v2-B_Cu.gbr, tessel-v2-B_Mask.gbr, tessel-v2-B_Paste.gbr, tessel-v2-B_SilkS.gbr, tessel-v2-Edge_Cuts.gbr, tessel-v2-F_Cu.gbr, tessel-v2-F_Mask.gbr, tessel-v2-F_Paste.gbr]
2015-12-21 adds fcc and ce cert silk and fcc id
    [tessel-v2-coprocessor.sch, tessel-v2-io.sch, tessel-v2-mediatek-flash.sch, tessel-v2-mediatek-ram.sch, tessel-v2-mediatek-rf.sch, tessel-v2-mediatek-usb.sch, tessel-v2-mediatek.sch, tessel-v2-power.sch]
2015-12-21 gerber export
    [tessel-v2-B.Cu.gbr, tessel-v2-B.Mask.gbr, tessel-v2-B.Paste.gbr, tessel-v2-B.SilkS.gbr, tessel-v2-Edge.Cuts.gbr, tessel-v2-F.Cu.gbr, tessel-v2-F.Mask.gbr, tessel-v2-F.Paste.gbr]
2015-12-28 fixes mirrored text
    [tessel-v2.kicad_pcb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]
2015-12-28 save, close project
    [tessel-v2.kicad_pcb]
2015-12-28 Mirrors C512, last unflipped ref des
    [tessel-v2.kicad_pcb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]
2016-02-02 Fix kicad library submodule dep
2016-02-11 updates fcc id and version number on board and back silk gerbers
    [tessel-v2.kicad_pcb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]
