tessel/t2-hardware/(notices)

Notices in the files:
tessel-v2.sch:
Copyright 2015 Technical Machine Inc.
CC-BY-SA or Solderpad, at your option.
v2.sch:
Copyright 2014 Technical Machine Inc.
